xehp/drekkar_stm32_scpi/hw/readme.pdf

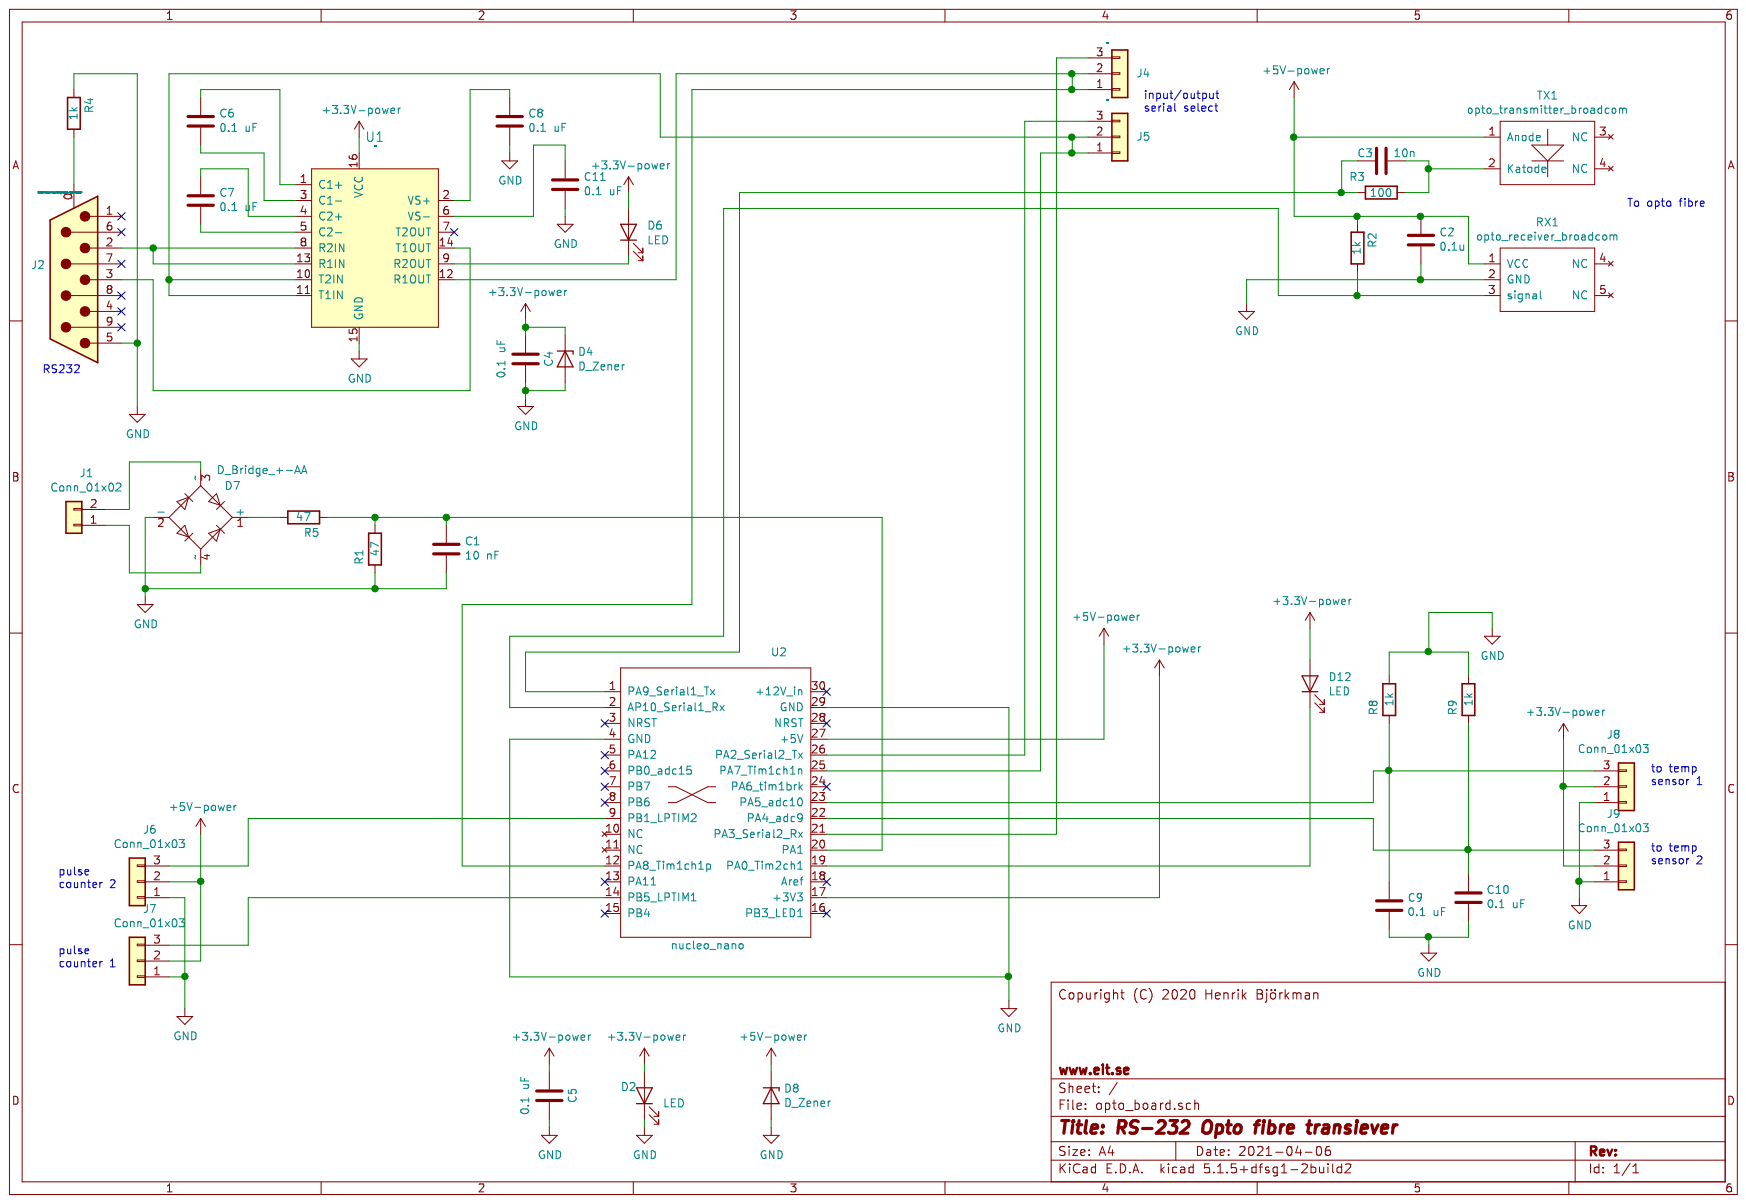
[picture p1: page 1]
