xehp/drekkar_stm32_scpi/hw/kicad/readme.pdf

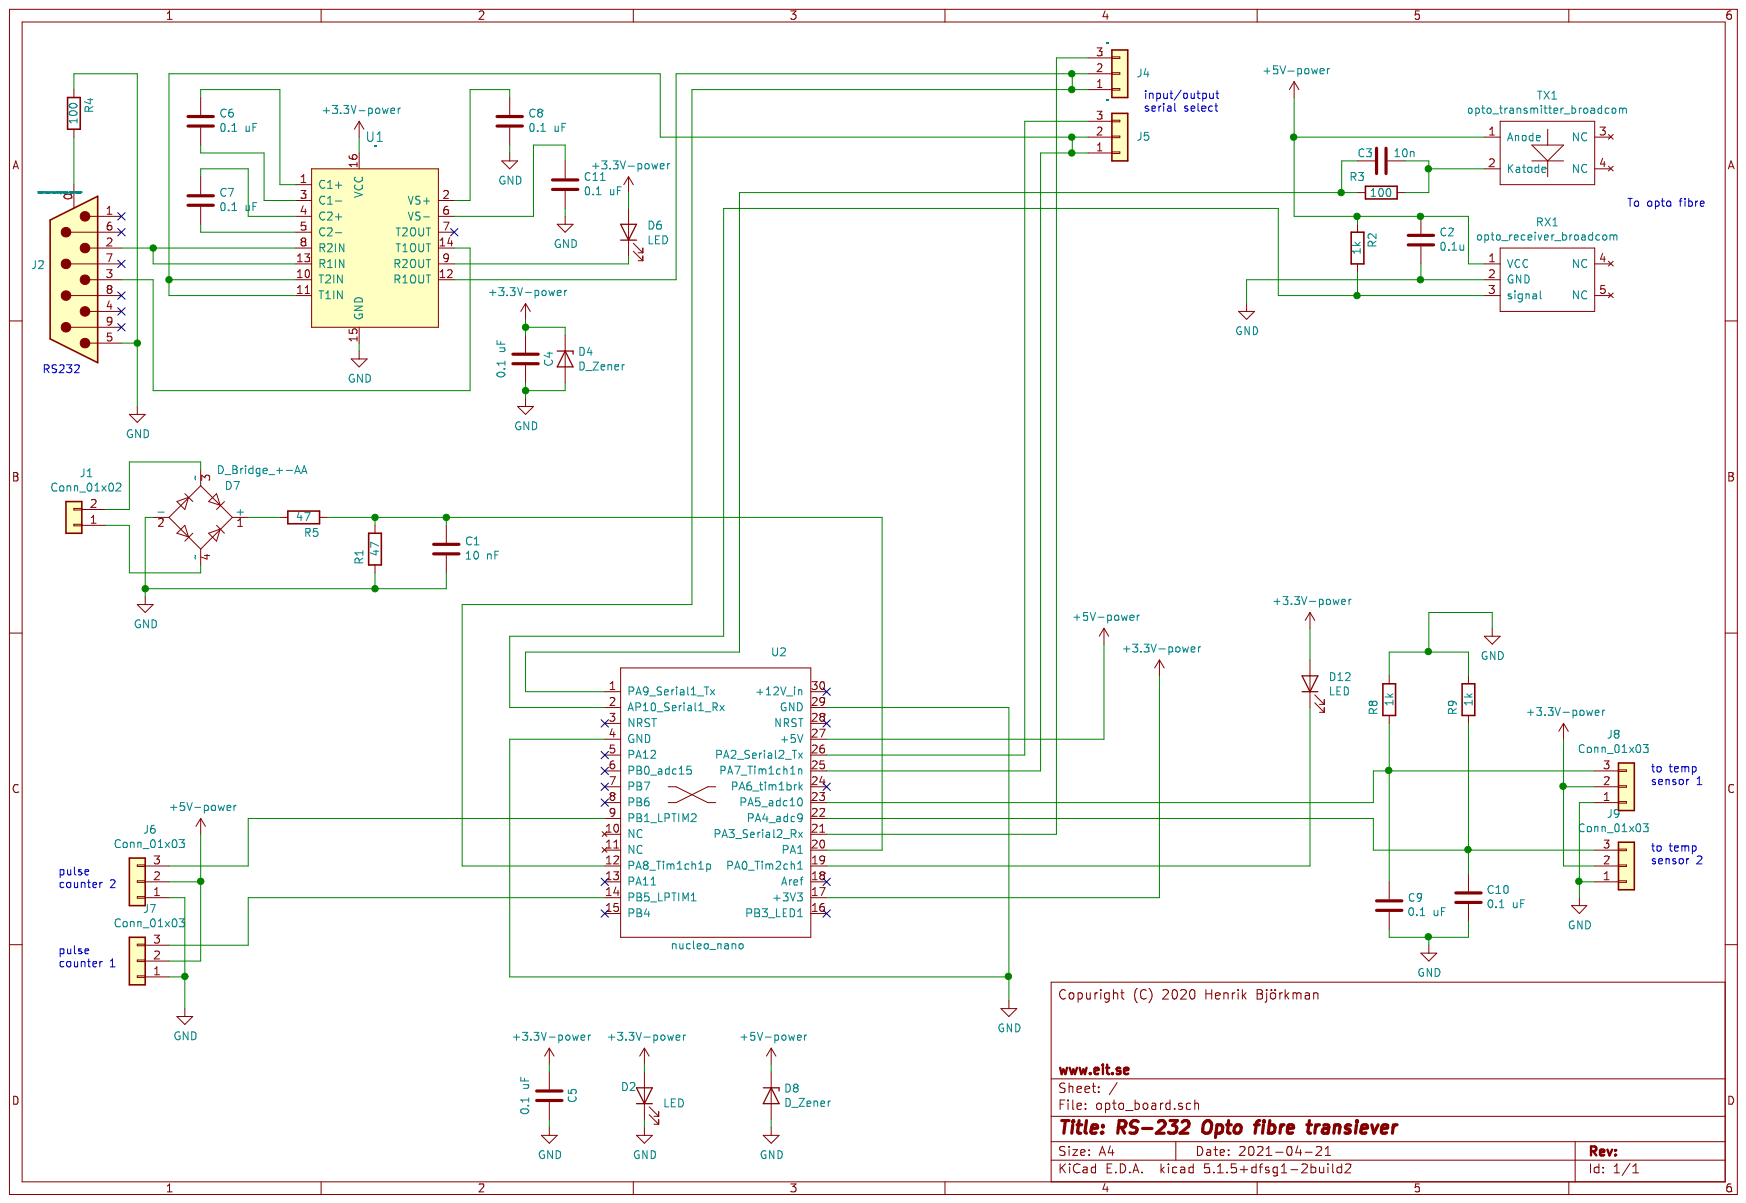
[picture p2: page 1]
