xehp/drekkar_stm32_scpi/hw/kicad/opto_board.kicad_pcb

## KiCad design hw/kicad/opto_board.kicad_pcb (2021-09-27)

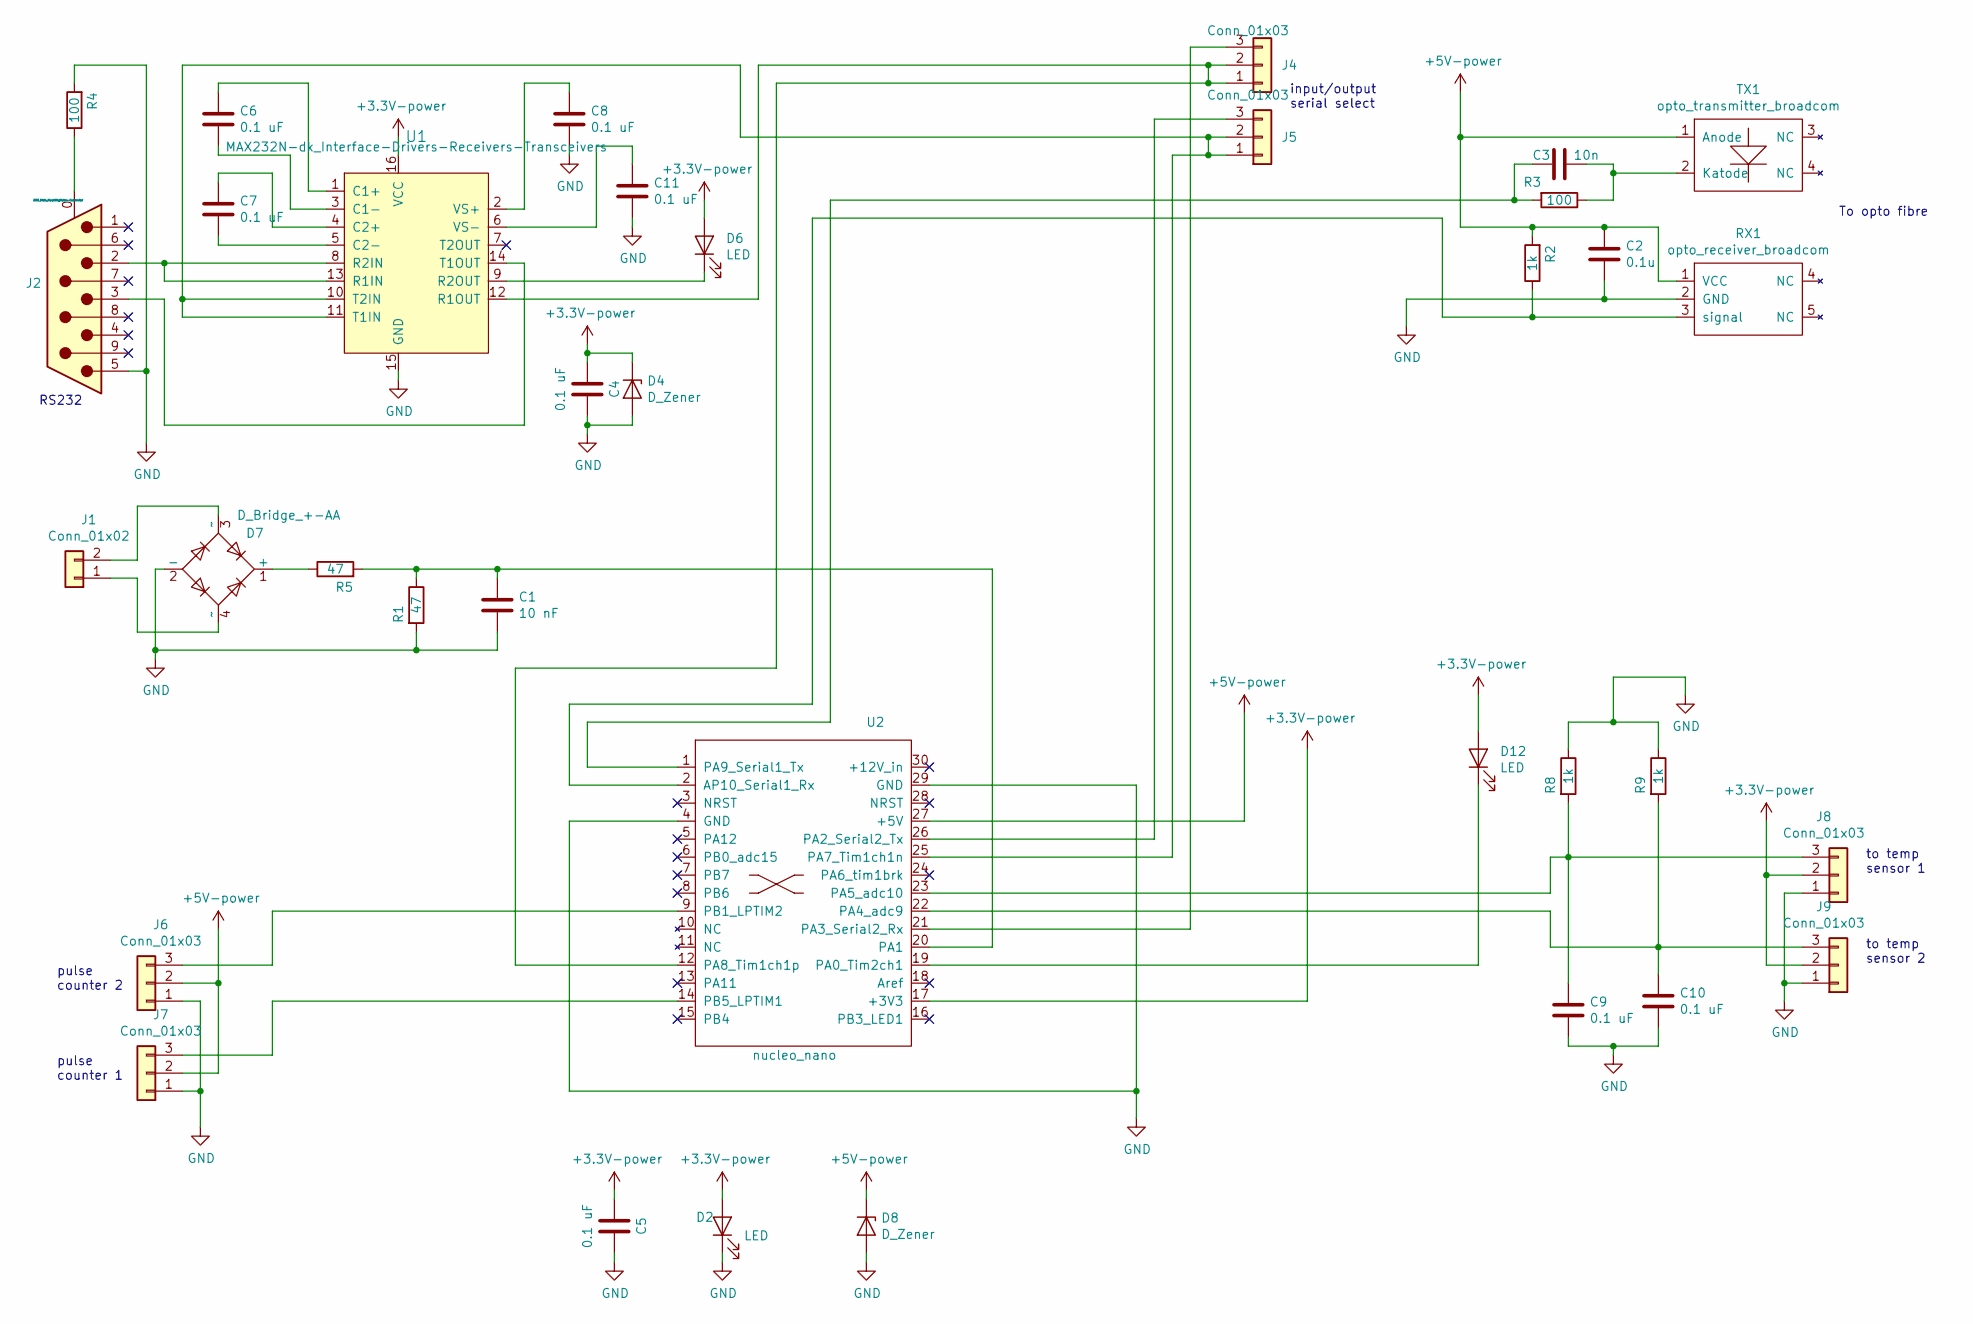
[picture p3: schematic opto_board.sch, RS-232 Opto fibre transiever]

Parts:
C1: 10 nF; C_Disc_D3.8mm_W2.6mm_P2.50mm
C2: 0.1u; C_Disc_D3.8mm_W2.6mm_P2.50mm
C3: 10n; C_Disc_D3.8mm_W2.6mm_P2.50mm
C4, C5, C6, C7, C8, C9, C10, C11: 0.1 uF; C_Disc_D3.8mm_W2.6mm_P2.50mm
D2, D6, D12: LED; LED_D3.0mm
D4, D8: D_Zener; D_DO-41_SOD81_P3.81mm_Vertical_AnodeUp
D7: D_Bridge_+-AA; Diode_Bridge_DIP-4_W7.62mm_P5.08mm
J1: Conn_01x02; Molex_KK-254_AE-6410-02A_1x02_P2.54mm_Vertical
J2: DB9_Male_MountingHoles-Connector; DSUB-9_Male_Horizontal_P2.77x2.84mm_EdgePinOffset7.70mm_Hou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
J4, J5: Conn_01x03; PinHeader_1x03_P2.54mm_Vertical
J6, J7, J8, J9: Conn_01x03; Molex_KK-254_AE-6410-03A_1x03_P2.54mm_Vertical
R1, R5: 47; R_Axial_DIN0309_L9.0mm_D3.2mm_P2.54mm_Vertical
R2, R8, R9: 1k; R_Axial_DIN0207_L6.3mm_D2.5mm_P2.54mm_Vertical
R3, R4: 100; R_Axial_DIN0207_L6.3mm_D2.5mm_P2.54mm_Vertical
RX1: opto_receiver_broadcom; opto_receiver_broadwell
TX1: opto_transmitter_broadcom; opto_transmitter_broadwell
U1: MAX232N-dk_Interface-Drivers-Receivers-Transceive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; DIP-16_W7.62mm; MPN MAX232N; Digi-Key_PN 296-1402-5-ND
U2: nucleo_nano

Connections:
+3V3: C4.2, C5.2, D2.2 (A), D4.1 (K), D6.2 (A), D12.2 (A), J8.2, J9.2, U1.16 (VCC), U2.17 (+3V3)
+5V: C2.2, D8.1 (K), J6.2, J7.2, R2.2, RX1.1 (VCC), TX1.1 (Anode), U2.27 (+5V)
GND: C1.1, C2.1, C4.1, C5.1, C8.1, C9.1, C10.1, C11.1, D2.1 (K), D4.2 (A), D7.2 (-), D8.2 (A), J2.5, J6.1, J7.1, J8.1, J9.1, R1.2, R4.2, R8.1, R9.1, RX1.2 (GND), U1.15 (GND), U2.4 (GND), U2.29 (GND)
unnamed: C1.2, R1.1, R5.2, U2.20 (PA1)
unnamed: C3.1, R3.1, TX1.2 (Katode)
unnamed: C3.2, R3.2, U2.1 (PA9_Serial1_Tx)
unnamed: C6.1, U1.3 (C1-)
unnamed: C6.2, U1.1 (C1+)
unnamed: C7.1, U1.5 (C2-)
unnamed: C7.2, U1.4 (C2+)
unnamed: C8.2, U1.2 (VS+)
unnamed: C9.2, J8.3, R8.2, U2.23 (PA5_adc10)
unnamed: C10.2, J9.3, R9.2, U2.22 (PA4_adc9)
unnamed: C11.2, U1.6 (VS-)
unnamed: D6.1 (K), U1.9 (R2OUT)
unnamed: D7.1 (+), R5.1
unnamed: D7.3 (~~), J1.2
unnamed: D7.4 (~~), J1.1
unnamed: D12.1 (K), U2.19 (PA0_Tim2ch1)
unnamed: J2.0 (PAD), R4.1
unnamed: J2.2, U1.8 (R2IN), U1.13 (R1IN)
unnamed: J2.3, U1.14 (T1OUT)
unnamed: J4.1, J4.2, U1.12 (R1OUT), U2.12 (PA8_Tim1ch1p)
unnamed: J4.3, U2.21 (PA3_Serial2_Rx)
unnamed: J5.1, J5.2, U1.10 (T2IN), U1.11 (T1IN), U2.25 (PA7_Tim1ch1n)
unnamed: J5.3, U2.26 (PA2_Serial2_Tx)
unnamed: J6.3, U2.9 (PB1_LPTIM2)
unnamed: J7.3, U2.14 (PB5_LPTIM1)
unnamed: R2.1, RX1.3 (signal), U2.2 (AP10_Serial1_Rx)

Notes on the sheet:
to temp sensor 1
to temp sensor 2
pulse counter 1
pulse counter 2
input/output serial select
RS232
To opto fibre

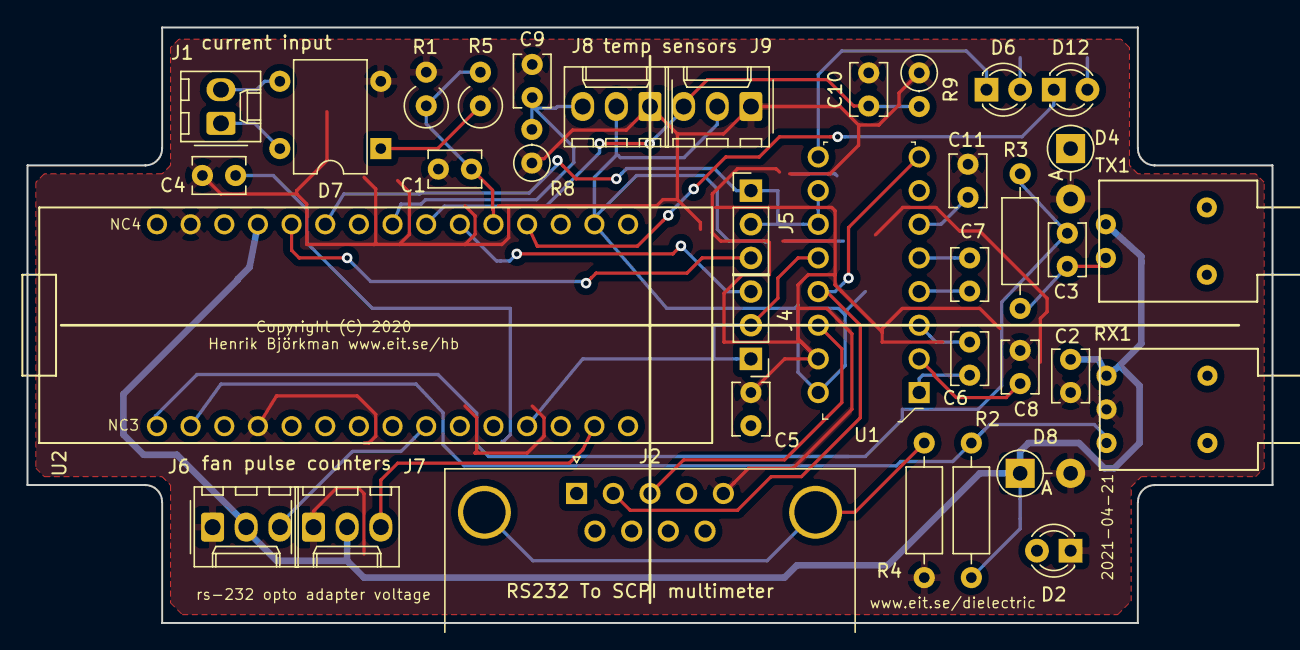
[picture p4: board opto_board.kicad_pcb from above]

Board: 2 copper layers, 94.0 x 45.0 mm, 36 parts (0 on the bottom side), 29 nets.
