xehp/drekkar_stm32_scpi/sw/src/debugLog.h

#ifndef DEBUG_LOG_H_
#define DEBUG_LOG_H_

void debug_print(const char* str);
void debug_print64(int64_t num);

void debug_print_hex_4(uint32_t i);
void debug_print_hex_8(uint32_t i);
void debug_print_hex_16(uint32_t i);
void debug_print_hex_32(uint32_t i);
void debug_print_hex_64(uint64_t i);

void debug_putchar(int ch);

#endif
