xehp/drekkar_stm32_scpi/(commit log)

2021-04-21 Added HW schematics
    [opto_board-2019-03-29-18-14-51.sch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]
2021-04-21 added eit_kicad_libraries
    [opto_board.sch]
2021-04-21 updated gerber files
    [opto_board-B_Cu.gbr, opto_board-B_Mask.gbr, opto_board-B_Paste.gbr, opto_board-B_SilkS.gbr, opto_board-Edge_Cuts.gbr, opto_board-F_Cu.gbr, opto_board-F_Mask.gbr, opto_board-F_Paste.gbr]
2021-04-21 moved kicad files to their own folder
    [opto_board-2019-03-29-18-14-51.sch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]
2021-09-27 improved SW/HW, added bom.txt & readme.pdf
    [opto_board-B_Cu.gbr, opto_board-B_Mask.gbr, opto_board-B_Paste.gbr, opto_board-B_SilkS.gbr, opto_board-Edge_Cuts.gbr, opto_board-F_Cu.gbr, opto_board-F_Mask.gbr, opto_board-F_Paste.gbr]
