xehp/drekkar_stm32_scpi/(notices)

Notices in the files:
hw/kicad/opto_board.kicad_pcb:
Copyright (C) 2020
hw/kicad/opto_board.sch:
Copuright (C) 2020 Henrik Björkman
